ideocentric/ribbon-synth/hardware/enclosure/#bud-cu-477-drill-patterns.dxf

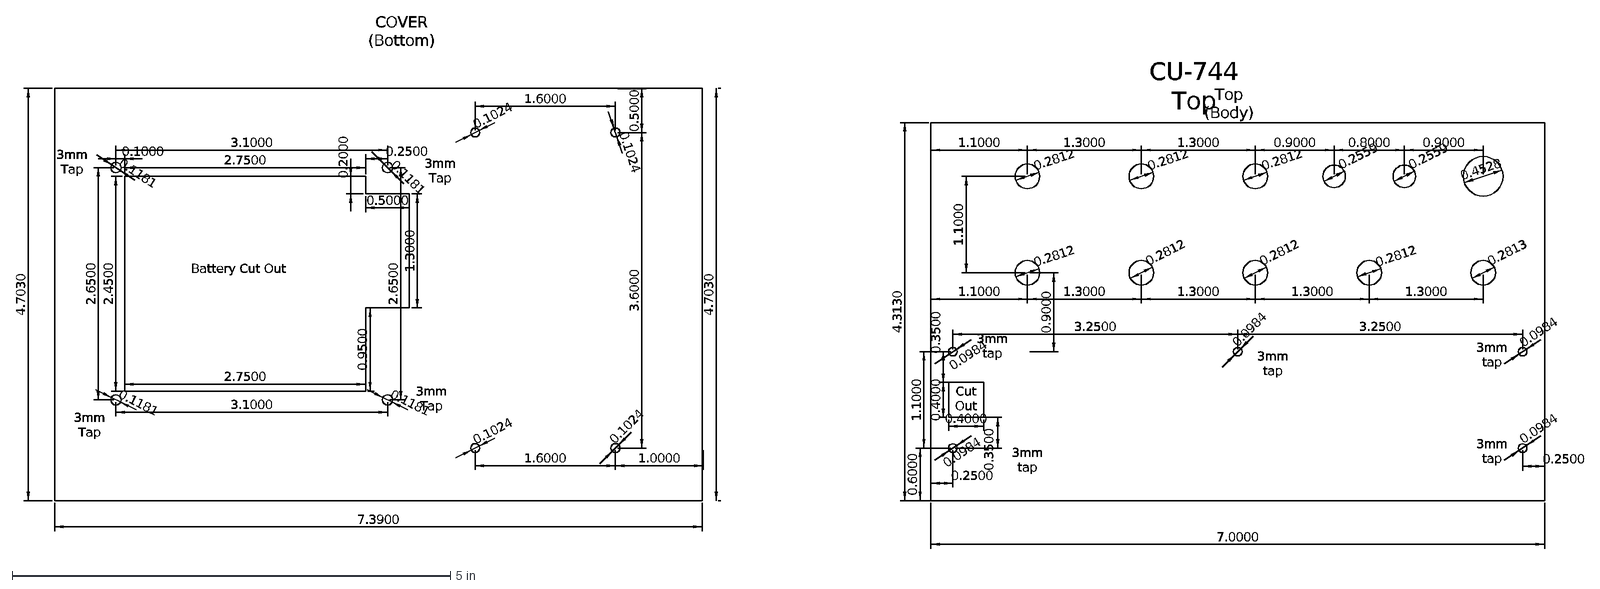
[picture p1: CAD file, 2026-04-06]
hardware/enclosure/#bud-cu-477-drill-patterns.dxf
7.3900
4.7030
COVER (Bottom)
4.3130
7.0000
3.2500
1.1000
0.4000
0.3500
0.6000
0.0984
0.2559
0.2812
0.2813
Top (Body)
0.2500
1.3000
0.9000
3mm tap
CU-744 Top
1.6000
0.5000
3.6000
1.0000
0.1024
3.1000
2.6500
0.1000
2.7500
2.4500
0.9500
0.2000
0.1181
3mm Tap
Battery Cut Out
Cut Out
0.4528
0.8000
